DevcodeSulaiman/Pediatric-Smart-Toothbrush/(commit log)

2026-10-08 Initial release: Pediatric Smart Toothbrush
    A real-time embedded brushing feedback system for children.
    Hardware:
    - ESP32 WROOM-32 microcontroller
    - MPU9255 IMU with Madgwick AHRS (100 Hz, quaternion-based)
    - Force-Sensitive Resistor (RC timing method, 0.1uF cap)
    - 0.91-inch SSD1306 OLED display (128x32, I2C)
    - DFPlayer Mini audio module
    - Active buzzer + LED feedback actuators
    Firmware highlights:
    - Dual-frequency non-blocking loop: 100Hz IMU + 12.5Hz UI
    - Madgwick 6-DOF sensor fusion (beta=0.1)
    - Piecewise linear force estimation (6-point calibrated V-F curve)
    - 2.0 N force threshold, 45deg +/-15deg angle enforcement
    - 2-minute session timer with audio
    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
2026-10-11 Add Smart Brush final integrated code
    This file contains the final integrated code for the Smart Brush project, featuring MPU9255 orientation, FSR pressure detection, SSD1306 OLED display, DFPlayer Mini music playback, Bluetooth control, and a brushing timer.
2026-10-11 Enhance README with firmware details and constants
    Updated README to include new constants and calibration details for firmware. Added sections for OLED, Bluetooth, and DFPlayer configurations.
