DevcodeSulaiman/Pediatric-Smart-Toothbrush/(notices)

Notices in the files:
README.md:
License: MIT
